gianlucarenzi/RetroBitLab-Library/README.md

# RetroBitLab-Library
Collection stuff for Kicad projects

This repository is needed when cloning other repos from my github space.
All project are usually relative to my home computer path, but this Library is needed at the same level of the other projects.

E-Mail me for any question you may have:

Gianluca Renzi icjtqr@gmail.com

Happy coding and hacking! ;-)
