gianlucarenzi/RetroBitLab-Library/(commit log)

2019-01-06 First Import
    This library contains all stuff needed to use my Kicad Projects.
2019-01-20 added a new mounting hole
2019-02-11 Modified the Footprint for ECI Bus
2019-02-11 Modified footprint
2019-02-28 Added floppy edge connector
2019-03-01 Increased the drill holes
2019-03-21 Added IDC Header / Sockets / IDE 44 Pins
2019-04-18 Added GNU SPL Small for SilkScreen Top
2019-04-24 Added PCI 64 pin vertical Code Molex: 0877159106
2019-04-24 Added Molex mini PCI connector 64 pins
2019-06-02 Added some components (PCI Express SLOT, EdgeConnectors, Capacitors...)
2019-09-07 modified pin numbers
2019-10-14 Added horizontal IDC 40 PIN HEADER with LOCK
2019-10-14 Added MCA-182 connector
2020-10-26 Added handsoldering for LQFP-144-24x24-0.50mm
2020-11-21 New PCB 2.54mm 24 pin keyboard adapter with Edge Flat Cable 34 Pin (Floppy cable type)
2020-12-29 Added Footprint with Cherry MX Switch (Brown) and stabilizers where needed.
2021-02-07 New FPC 32 pin flat cable for keyboard
2021-02-07 Modified using the upgraded Kicad 5.1 3d packages library
2021-03-09 Added Footprint Library for displays
2021-03-11 Added some libraries Modified the name of the FFC 1.25 Molex 90 degrees angle connector
2021-03-22 Added some other connectors
2021-03-22 Modified for global installation Kicad
2021-04-03 1.5U with special oval hole as in the original XE plastic support. It should not be needed as the machanical keys are quite higher than the orignal ones. After all with the adaptar, the original keys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
2021-04-14 Added some components footprint
2021-04-14 Added a strip header/socket
2021-04-16 Added CUI USB U2J-AH-4-TH as USB A Host Connector
2021-04-16 Added RJ10 Amiga 1000 Keyboard Connector
2021-04-16 Added USB Cable Logo Bitmap
2021-04-16 Added DIP-Socket and TexTools
2021-04-28 Some models are referring the packages/kicad/... now obsolete because they are part of Kicad 5 Others are referring to the original 3d package but we need to change path
2021-05-18 Added ground to the mechanical holes to improve quality of SPI OLED Display noise.
2021-06-13 Added Thermal Relief for pin 65 QFN PIC32
2021-06-13 QFN PIC32 64 OLED GND HOLES
2021-06-22 Added FPC64 Symbol Connector 64POS 0.5MM SMD
2021-06-25 Pistorm (NEG) SilkScreen Logo MC68000 and its FEMALE Version added
2021-07-02 Added Raspberry Pi 3 WRL file for physical tests
2021-08-08 New DIP64 M68000 Replacement socket MALE pin header
2021-08-08 Renamed. Correct footprint?
2021-10-20 Wrong Footprint. The datasheet lacks of the secondary contacts, so testing it with Voltage Multimeter, it gives me a lot of hints. The versions up to 1.6 cannot be used with the USB Micro Connector. 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
2021-12-16 RaspberryPi Pico
2021-12-20 3D Keycaps for switches
2022-01-10 Added MX with LED/noLED/Flipped
2022-01-10 Added MX 1U with LED (like CAPS LOCK on the Amiga)
2022-01-11 Added Symbol for STM32F401 Developer Kit
2022-01-11 Footprint for STM32F401 Developer Kit. It should uses the 3d WRL file
2022-01-11 3D shape for the footprint
2022-01-11 3D PCB Board Corrected Added 2 headers 2x16 female
2022-01-12 Added. Other footprints must be used. Not finished yet.
2022-01-12 Holes and CourtYard for 9U spacebar. Must be used with the 7U switch
2022-01-12 Added stabilizers and cherry mx switch
2022-01-13 Added MX_Alps_Hybrids Modified the Footprint for STM32F401-DK
2022-01-23 Thinner connector outline. To be checked
2022-01-26 Symbol QFN for PIC32 with all pin routed to pads. More or less like an adapter QFN/TPH?
2022-02-04 Upgraded with Pico
2022-02-04 Added 3D shape of the STM32F401-DK evaluation board
2022-02-07 Updated for Reset Switch
2022-02-09 Now the Cherry MX Switches for PCB 3D has all 3D objects: switch + stabilizers + keycap DSA (without legends)
2022-02-09 Atari XE Function Keys. STL model by Axel Gussman
2022-02-09 Added STEP models for DSA. It's better when import KiCAD project into FreeCAD for step files
2022-02-09 All sources from DSA profile keycaps (stl and step)
2022-02-24 New STEP file, modified for a better stability and a better fitting on the Cherry MX switches
2022-02-24 FreeCAD project: new STEP file, modified for a better stability and a better fitting on the Cherry MX switches
2022-03-13 New vertical Molex FFC/FPC connector (End Of Life)
2022-11-07 Added USB A SMT connector from LCSC
2022-11-10 Added PLCC 44 socket footprint (from original KiCAD library) plus the 3D object
2024-11-06 Added STM32F401-EVK Symbol. Part A & B
2024-11-06 Added STM32F401-EVK Footprint. 2x32 2.54" headers
2025-07-17 MODULE ESP32 DEVKIT V1
2025-07-17 ESP32 NODEMCU DEVKIT V1 Module Added
2025-07-17 ESP32 NODEMCU DEVKIT V1 Module Corrected
2025-07-17 Now the 3D model has pin headers instead of pin sockets
2025-07-17 RP2040 footprint
2025-07-18 Modificato simbolo ESP32 DEVKIT V1 (vanno aggiunti in serigrafia i nomi dei pin Aggiunto connettore USB-C orizzontale
2025-07-21 USB-C connector better symbol
2025-07-23 Added symbol logo for ESP32 BOBOARD
2025-07-23 Added png for ESP32BOBOARD (AI Generated by ChatGPT)
2025-07-23 Added symbols for ESP32BOBOARD Logo (AI Generated by ChatGPT) in different sizes
2025-07-28 Added some components (logic ports, ESP32-PICO-D4 MCU, WM Audio Codec)
2025-07-29 Library Capacitors 1210, 1206, 0805 & 0603. Various values
2025-07-29 Library Resistors 1210, 1206, 0805 & 0603. Various values
2025-07-29 Added LED 1210 & 1206 GREEN and RED
2025-07-29 Added other resistor values
2025-07-31 Added Ferrite bead 0805 & 1206 4A 100Ohm 100Mhz
2025-08-01 Added 2 SPST 24V 25mA Black 3,000 Cycles Slide, Recessed SMD-4P,4.1x5.4mm DIP Switches ROHS
2025-09-01 Added LDO 1.5V, 1.8V, 2.5V & 3.3V
2025-09-04 Added MAX40200 as barrier protection IC for double powering board (i.e. Plug and USB @ same time)
2025-09-09 Layer of the ESP32-PICO-D4 text changed to F.Fab instead of F.SilkS
2025-09-10 LED 0805
2025-09-17 Aggiunti simboli: AMS1117-1.2 LVDO SOT-223 CUI SJ-3523-SMT-TR Audio Stereo 3.5mm Jack
2025-09-17 Aggiunto footprint CUI SJ-3523-SMT-TR Audio Stereo 3.5mm Jack
2025-09-17 Aggiunto 3D CUI SJ-3523-SMT-TR Audio Stereo 3.5mm Jack
2025-09-19 Added Capacitor 100uF
2025-09-19 2x16 Pin header SMD LCSC 2.54mm
2025-10-09 as KiCAD 6+ wants
2025-10-13 Added 1K5 & 22R resistors
2025-10-13 Added Schottky Diode CUS10S30,H3F and its alias DIOSCH30V as 30V reverse voltage, 0.4V @ 1A SOD-323 SC-76
2025-10-17 Added Quartz Crystal Oscillator 24.756Mhz SMD3225 4 pins Added HDMI type A connector HDMI-A SMD USB, DVI, HDMI Connector Assemblies ROHS Added FB080590R100MHZ850mA 150mΩ ±25% 90Ω@100MHz 0805 Ferrite 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
2025-10-17 Added HDMI type A connector HDMI-A SMD USB, DVI, HDMI Connector Assemblies ROHS
2025-10-17 Added MS9288C I2C QFN-48-EP(6x6) Video Processing ROHS Macrosilicon MS9288C Analog RGB to HD Converter VGA HDMI
2025-10-17 Added LCSC Pin Header 2x08 SMD
2025-10-24 Added Pin Header BOX IDC 2x8 SMD 2.54mm
2025-10-30 Modificato simbolo del oscillatore al quarzo con 4 pin (1 clkin, 3 clkout, 2 e 4 GND)
2025-10-30 Added IDC Box Header Pin 2x05 P2.54mm SMD
2025-11-01 New Tantalum Capacitor. This should be more available @ LCSC
2025-11-03 STM32F4XX-BOARD Module support
2026-02-20 Correct Pinout: it was counterclock. This should be checked with Amiga Explorer PCB http://amigapcb.org/ Thanks to Paolo Colombo again! ;-)
2026-06-03 Added: 2x16 SMD 2.54mm HEADER Vertical C6332241 LCSC SN74HCT10PW C54929581 LCSC SN74HCT138 C352958 LCSC
2026-06-10 added ESP32-S3FN8
2026-09-01 No more 27pF Capacitor
2026-09-01 new 27pF SMD Capacitor 50V 5% COG
2026-10-21 ESP32-S3FN8 QFN56: solder mask margin 0.04 mm on perimeter pads
    With 0.102 mm per side the 0.22 mm pads got 0.424 mm openings on a 0.4 mm
    pitch, so the openings merged and no solder mask was left between pins.
    0.04 mm gives 0.30 mm openings and a 0.10 mm mask web. Exposed pad
    unchanged.
2026-10-23 BAT43 Schottky Diode Added
2026-10-26 SN74LVC00 and SN74LVC1G07DBVR symbols, 0R datasheet link
    - SN74LVC00 (TI SN74LVC00APWR, TSSOP-14, LCSC C7803): quad 2-input NAND,
    aliases 7400, 74HC00, 74HCT00, 74LS37.
    - SN74LVC1G07DBVR (TI, SOT-23-5, LCSC C7829): single buffer with
    open-drain output. VCC and GND pins are visible, so they are wired
    explicitly and never join a global VCC net by name.
    - CRES0805 0R / CREZ08051% (LCSC C328378): datasheet link updated in the
    symbol and in the documentation of both names.
2026-10-26 C64-EXPANSION-PORT symbol and C64-EXPANSION-CARTRIDGE footprint
    Commodore 64 expansion (cartridge) port, cartridge side: 2x22 gold
    fingers at 2.54 mm pitch, pins 1-22 on F.Cu and A-Z on B.Cu (pin A
    behind pin 1), board edge at y = 0. Symbol laid out like
    ATARI-CARTRIDGE, pins 1-22 on the left and A-Z on the right. Finger
    length (7.62 mm) to be checked against a real cartridge.
2026-10-29 Fix 3D models: add Crystal 2520 STEP, drop missing PLCC-44 model
    Add Crystal_SMD_2520-4Pin_2.5x2.0mm.step from the official KiCad library:
    KiCad 5 never shipped a 3D model for that footprint.
    PLCC-44_THT-Socket_3D referenced Package_LCC.3dshapes/PLCC-44_THT-Socket.wrl,
    which no KiCad version ships; the 54020-44030LF model already covers it.
2026-10-30 ESP32-S3 thermal vias, CH340T on SSOP-20 with 0.45 mm pads
    - IC_ESP32-S3FN8-QFN40P700X700X90-57N: 3x3 thermal vias (0.3/0.2 mm,
    1.2 mm pitch) in the exposed pad 57, as on the QFN-48 footprint.
    - SSOP-20_5.3x7.2mm_P0.65mm_Pad0.45: copy of the KiCad footprint with
    pads narrowed from 0.50 to 0.45 mm, leaving 0.20 mm between pads
    instead of exactly the 0.15 mm board clearance.
    - USBCH340T now uses the new SSOP-20 footprint.
2026-10-31 CONN_AUDIO_JACK_3.5_PJ313D: SHOU HAN PJ-313D 3.5mm stereo jack (C668608)
    Footprint RetroBitLab:jack_3.5_pj313d-smt, pins 1 sleeve, 2 tip, 3 ring
    as the datasheet A/C/B contacts.
2026-10-31 ECS-2033-250-BN: now YXC OT3EL89CJI-111YLC-25M (C7471623)
    Same pinout, footprint and 3D model; value, LCSC code, datasheet,
    manufacturer and description changed. ECS part was short at JLCPCB.
2026-11-02 CRES0805 75R now KOA RK73H2ATTD75R0F (C317238), CCAP0603 100nF now FH 0603B104K101NT (C88219)
    The previous codes could no longer be assembled by JLCPCB: C20142801 had 7
    pieces left, C524962 was out of stock. Same value, package and ratings
    (75R 250mW 1%, 100nF 100V X7R; the 100nF description now says +-10% as
    the new part).
2026-11-04 CONN_SMD_HEADER_BOX_02x08: now HanXia HX JN2.54-2x8P TP H8.9 (C41376031)
    - Symbol renamed to CONN_SMD_HEADER_BOX_02x08_HX-JN2.54, new datasheet and LCSC part
    - New footprint IDC-Header_2x08_P2.54mm_Vertical_SMD with the datasheet land pattern
    - New 3D model IDC-Header-2x08_P2.54mm-VERT-SMD.STEP (from EasyEDA, converted with FreeCAD)
    - New footprint PinSocket_2x08_P2.54mm_Vertical_SMD_Bottom (mirrored socket for the bottom side)
    - The old PinHeader_BOX_2x08_P2.54mm_Vertical_SMD footprint is kept for existing boards
2026-11-04 Portable 3D model paths, drop missing keycap models, fix PES1-S5-S9-M fields
    - /home/debian/Progetti/RetroBitLab-Library/ replaced with ${KILIBPATH}/ in 31 footprints
    - Removed references to the nonexistent DSA-9u.step and DSA-ISO-ENTER.step
    - PES1-S5-S9-M.lib: MP and DESCRIPTION fields described the PES1-S12-S12-M, now aligned with RetroBitLab.lib
2026-11-04 CONN_HDMI_A: SH pin moved; default values of two symbols
    - CONN_HDMI_A: the shield pin SH at the lower right, pointing left
    - CONN_AUDIO_JACK_3.5_PJ313D, ECS-2033-250-BN: default value is the
    symbol name
    - C64-EXPANSION-PORT: pins 2-9 only reordered in the file (same pins)
